Mariam-zeqred/smart-poultry-farm/app/assets/images/LP.png

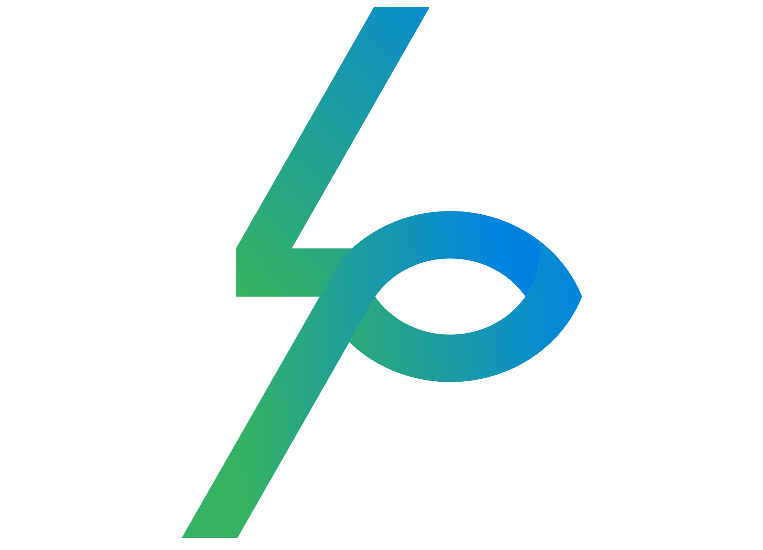
app/assets/images/LP.png
